magnus188/aegir/README.md

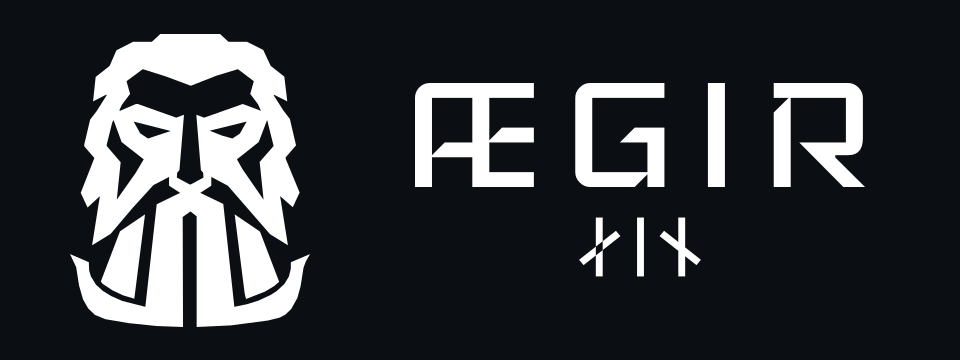
[picture p1: logo/aegir-lockup-dark.png]
Ægir 1 logo


Ægir is a work-in-progress trimix gas analyzer for technical diving. It is not
qualified as a breathing-gas safety instrument; use it at your own risk.

Made in Norway 🇳🇴.

## The name

In Norse mythology, Ægir (/ˈæːɣir/) is the giant who rules the sea. He is
known for hosting the gods in his halls adorned with gold and, together with
Rán, is the father of nine daughters who personify the waves.

The runes ᛅᛁᚾ are a Viking Age-style representation of einn, Old Norse for
“one”, marking the first version of the project: Ægir 1.

## Features

- Oxygen (O₂) and helium (He) sensor inputs, plus CO monitoring
- 4.3-inch touch screen for gas analysis, calibration and settings
- Mix calculations, dive planning and analysis history
- Desktop simulator with demo readings

**[Try the interactive browser demo](https://magnus188.github.io/aegir/).**

## Device design

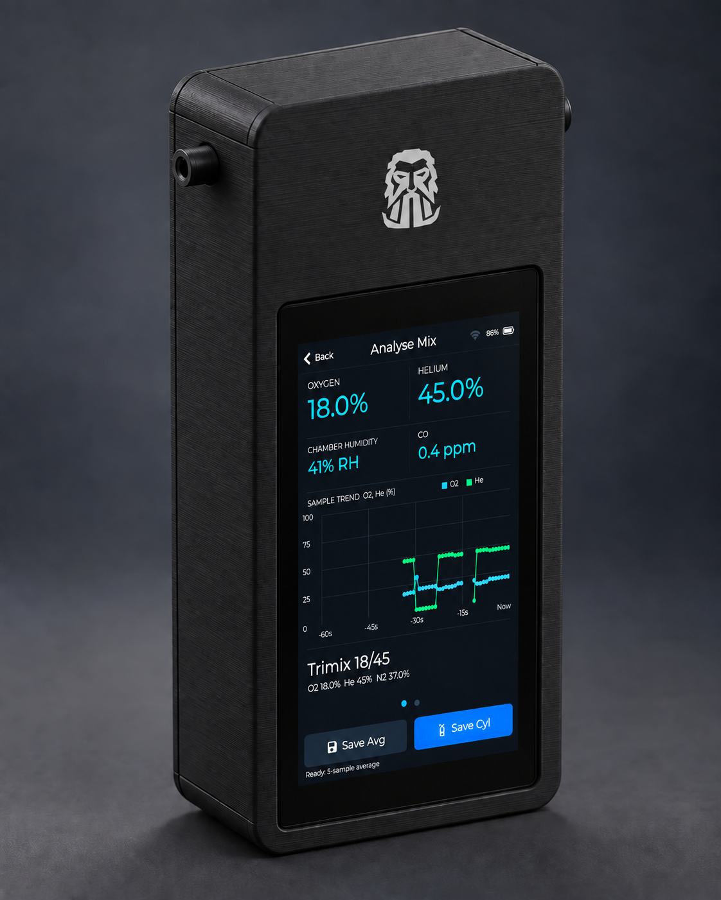
[picture p2: media/aegir-device-concept-render.png]
Concept render of the Ægir handheld trimix analyzer with a black 3D-printed case, white logo, plastic gas fittings and portrait touchscreen


*Concept render of the proposed enclosure and interface.*

## PCB and enclosure

The current prototype uses one PCB with a bottom-facing GCT USB4105-GF-A
USB-C connector. The matching enclosure retains the protected battery holder
and adds support around the connector.

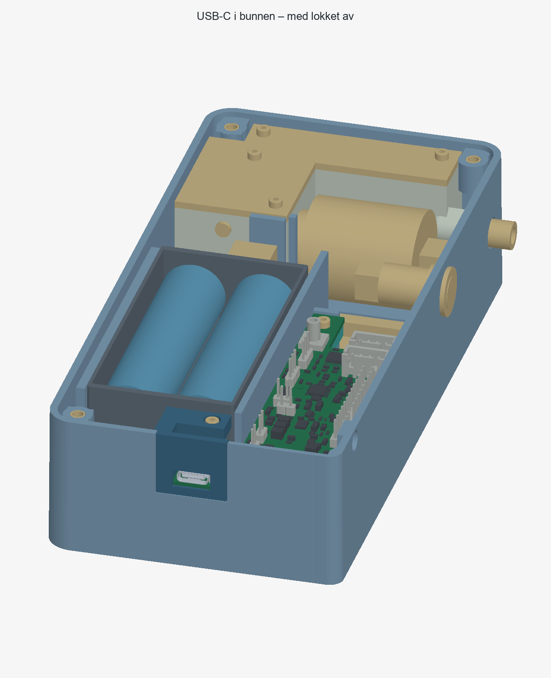
[picture p3: hardware/cad/pcb-v2-bottom/views/usb-bottom-open.png]
Current enclosure with integrated PCB and bottom USB-C support


Open the [KiCad project](hardware/pcb/analyzer-v2-bottom/Trimix_Analyzer.kicad_pro)
and [Fusion model](hardware/cad/pcb-v2-bottom/Trimix_Enclosure_PCB2_Bottom.f3d).
The [hardware guide](hardware/PCB2-BOTTOM.txt) describes the current files and
remaining prototype checks. Supplier and physical qualification are pending.

## Screenshots

These screens show the simulator with demo data. Swipe horizontally between
live analysis and analysis details; simulator profiles are in the top status banner.

| Main menu | Live analysis | Analysis details |
| :---: | :---: | :---: |
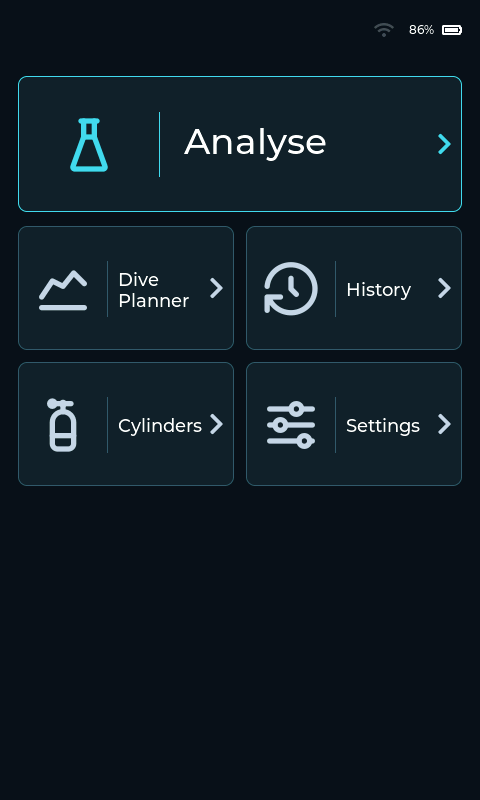
[picture p4: software/firmware/docs/screenshots/main-menu.png]
Main menu with Tabler icons
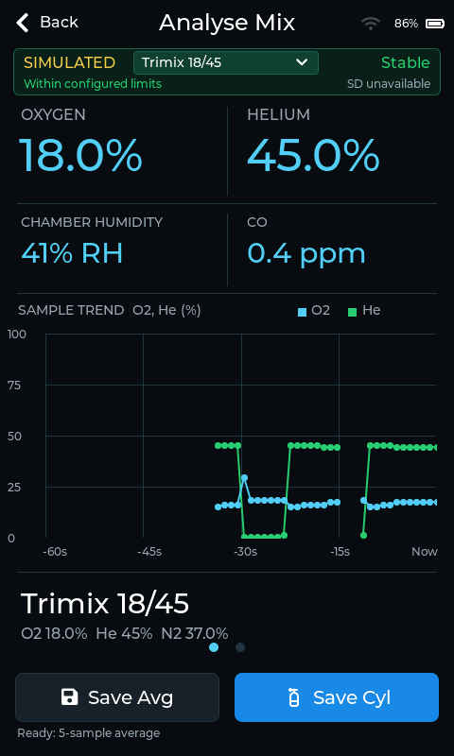
[picture p5: software/firmware/docs/screenshots/analysis-live.png]
Live gas analysis and sample graph
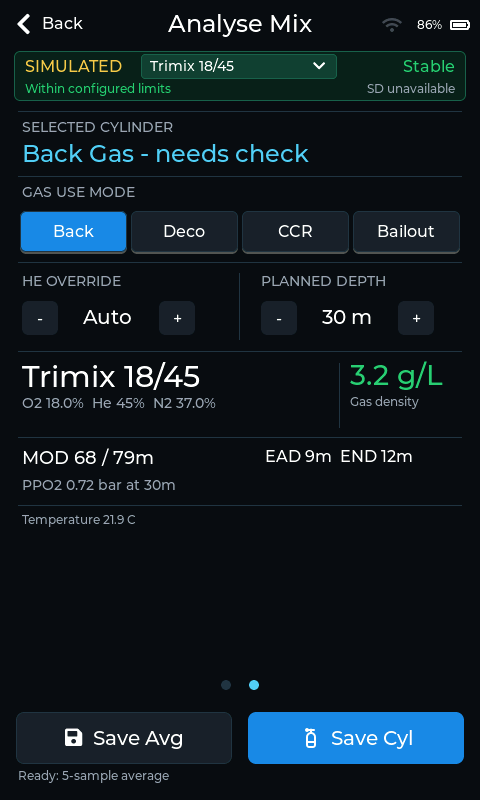
[picture p6: software/firmware/docs/screenshots/analysis-planning.png]
Selected cylinder and gas analysis details
|  |  |  |

| History | Cylinders | Settings |
| :---: | :---: | :---: |
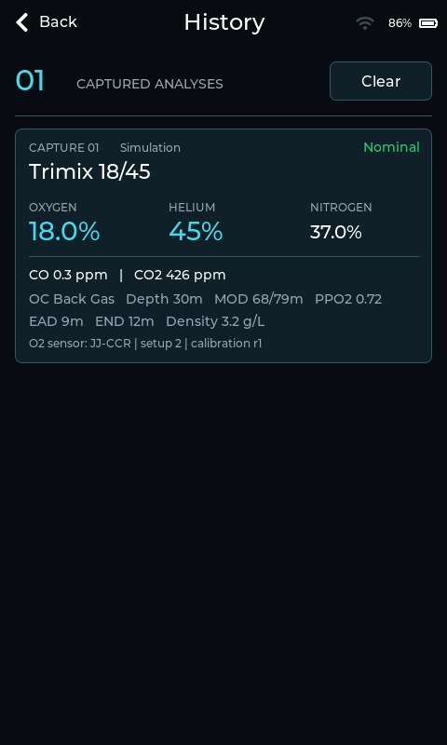
[picture p7: software/firmware/docs/screenshots/history.png]
Captured analysis history
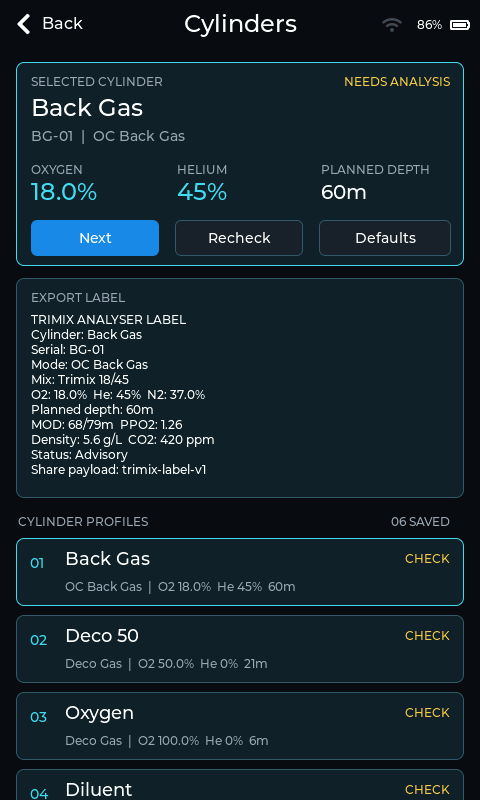
[picture p8: software/firmware/docs/screenshots/cylinders.png]
Cylinder profiles and export label
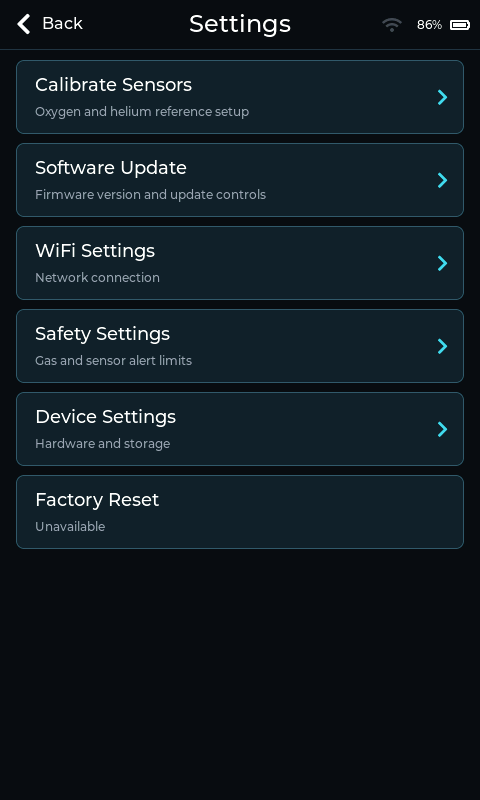
[picture p9: software/firmware/docs/screenshots/settings.png]
Settings menu
|  |  |  |

| Dive Planner | Device Settings |
| :---: | :---: |
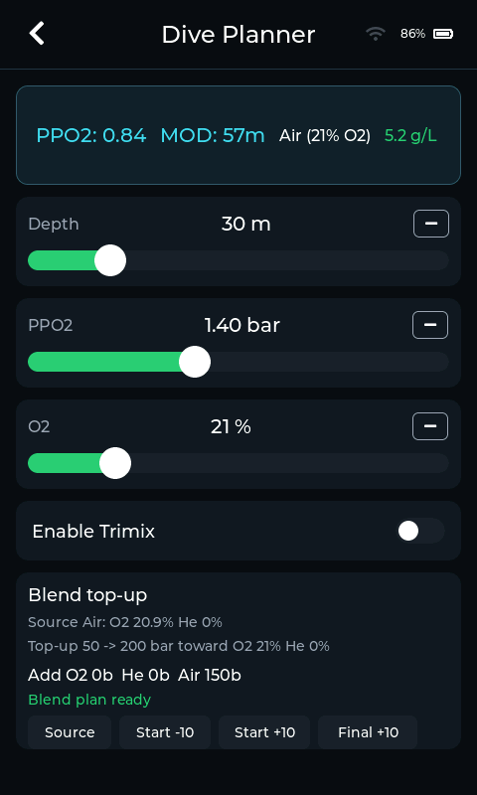
[picture p10: software/firmware/docs/screenshots/dive-planner.png]
Dive Planner with dark instrument header
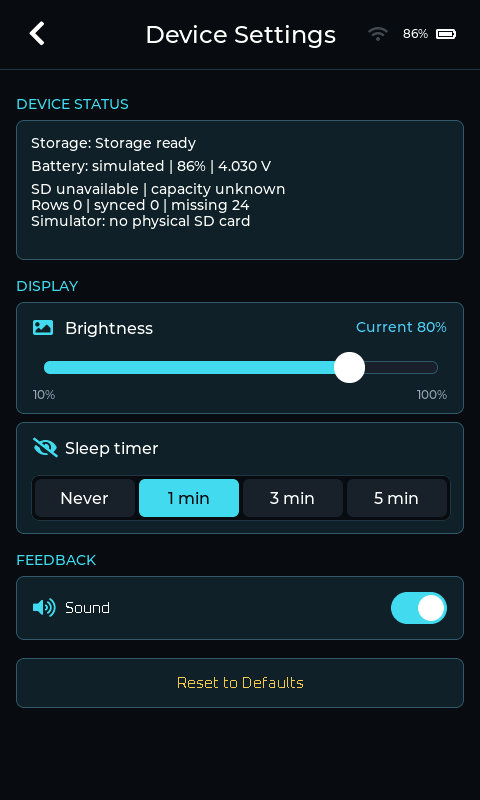
[picture p11: software/firmware/docs/screenshots/device-settings.png]
Device status with brightness slider and sleep controls
|  |  |

| Simulated high CO alert | Safety Settings |
| :---: | :---: |
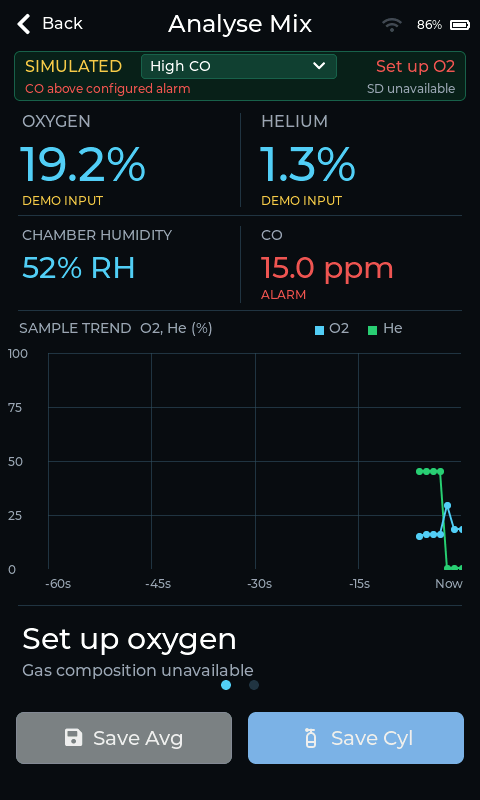
[picture p12: software/firmware/docs/screenshots/analysis-high-co.png]
Analyse shows a red CO alarm in the simulator
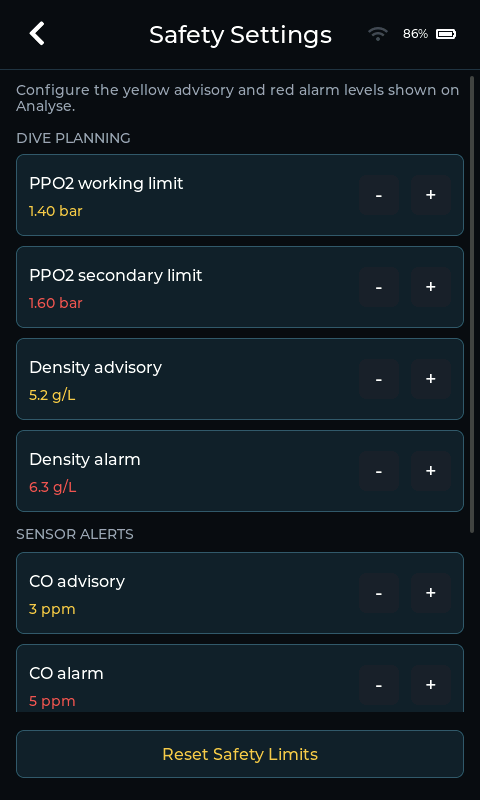
[picture p13: software/firmware/docs/screenshots/safety-settings.png]
Configurable advisory and alarm limits
|  |  |

## Run it

For the desktop simulator, install a C++ compiler, CMake, `pkg-config` and SDL2,
then run from the repository root:

```sh
make sim-deps
make sim ZOOM=0.75
```

Run the host tests with `make test`.

To build and flash the firmware on the Guition JC4880P443C_I_W ESP32-P4 board,
install Python 3.13 and run:

```sh
make setup-idf
make devices
make board-info PORT=/dev/cu.usbserial-110
make push PORT=/dev/cu.usbserial-110
```

Replace the example `PORT` with the port reported by `make devices`. See the
[firmware guide](software/firmware/README.md) for other build options.

## Files

- [Firmware and simulator](software/firmware/)
- [Current PCB 2.0 prototype](hardware/pcb/analyzer-v2-bottom/Trimix_Analyzer.kicad_pro), with integrated USB-C facing the bottom
- [Current enclosure CAD](hardware/cad/pcb-v2-bottom/Trimix_Enclosure_PCB2_Bottom.f3d), [STEP](hardware/cad/pcb-v2-bottom/Trimix_Enclosure_PCB2_Bottom.step) [H2D print bed](hardware/cad/pcb-v2-bottom/Trimix_PCB2_Bottom_H2D.3mf) and [STL package](hardware/cad/pcb-v2-bottom/Trimix_PCB2_Bottom_PrintParts.zip)
- [Hardware package guide and qualification status](hardware/PCB2-BOTTOM.txt); superseded deliverables remain in Git history
- [Logo](logo/README.md)

## Contributing and future ideas

Design reviews, measurements, documentation and software fixes are welcome.
Start with the [contribution guide](CONTRIBUTING.md) and
[open issues](https://github.com/magnus188/aegir/issues). The
[v2 investigation backlog](https://github.com/magnus188/aegir/milestone/1)
collects community suggestions without promising a release date.

Maintainers can use the [repository guide](.github/MAINTAINING.md). For
exploitable vulnerabilities, use the [private reporting route](SECURITY.md).

## Acknowledgements

A big thank you to [@tobiasruber](https://github.com/tobiasruber) for reviewing and
improving the PCB design. His help is a big reason this project is still alive
and moving forward.

## License

Software: [GPLv3](LICENSES/GPL-3.0-only.txt). PCB and CAD files:
[CERN-OHL-S-2.0](LICENSES/CERN-OHL-S-2.0.txt). The Ægir name and logo have a
separate [brand policy](logo/LICENSE.md). See the [license map](LICENSE.md)
for details and third-party files.
