magnus188/aegir/hardware/pcb/usb-input/reference/README.md

# Manufacturer reference

`GCT_USB4720_RevB_drawing.pdf` is the GCT USB4720 connector drawing retained
for land, cutout and mating-interface review. The
[manufacturer's published drawing](https://gct.co/files/drawings/usb4720.pdf)
is the source. This third-party document is not part of the project's own
design license.
