magnus188/aegir/hardware/cad/pcb-v2-bottom/FESTEMATERIELL-ENDREDE-FESTER.csv

Del | Antall | Bruk | Merknad
M2 x 7 mm | 2 | Kortfester | Samme skruelengde som tidligere
M2 x 5 mm | 2 | USB-støtte | Gjenbruk av tidligere USB-skruer
TC-M2x3.0 varmeinnsats | 4 | To kortfester og to USB-fester | Eksakt lagerbeholdning ikke bekreftet; prøv faktisk innsats i testutskrift
M3 x 8 mm | 4 | Baklokk | Tre bakfra og én fra høyre side; gjenbruk av opprinnelige skruer
Opprinnelig M3-innsats OD4.2 x5 | 4 | Baklokk | Tre i hovedhuset og én i den nye fliken på lokket; øvrige fester videreføres
