magnus188/aegir/media/reddit/aegir-product-concept-unbranded.png

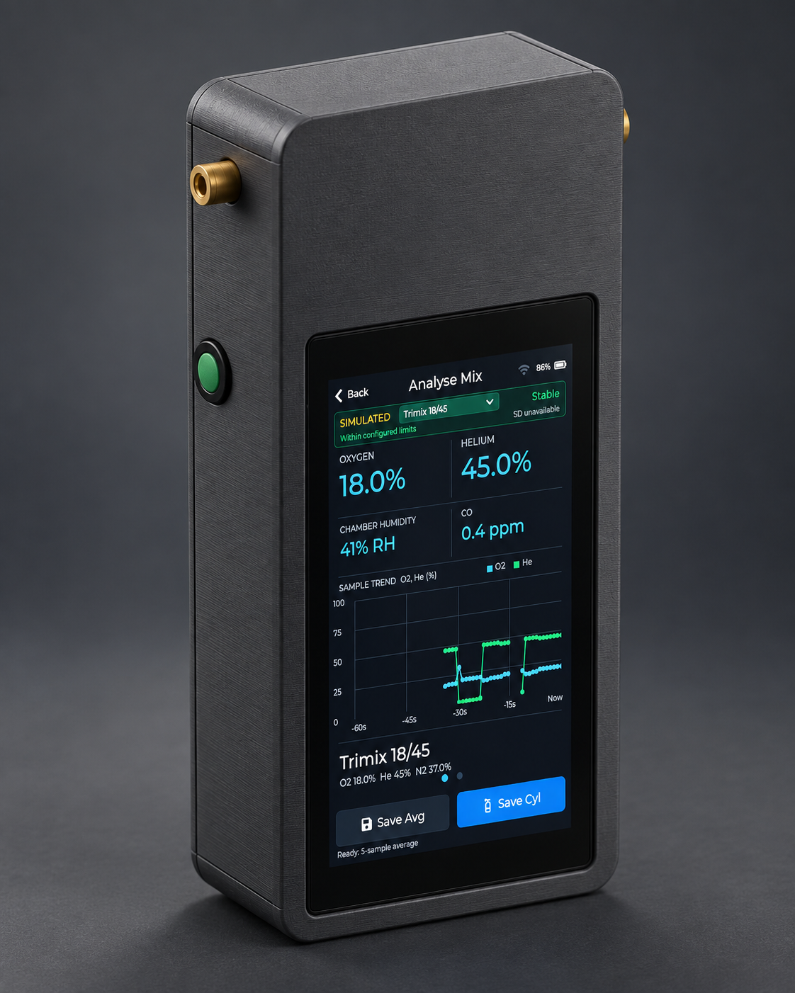
media/reddit/aegir-product-concept-unbranded.png
