magnus188/aegir/media/reddit/aegir-product-concept-v2.png

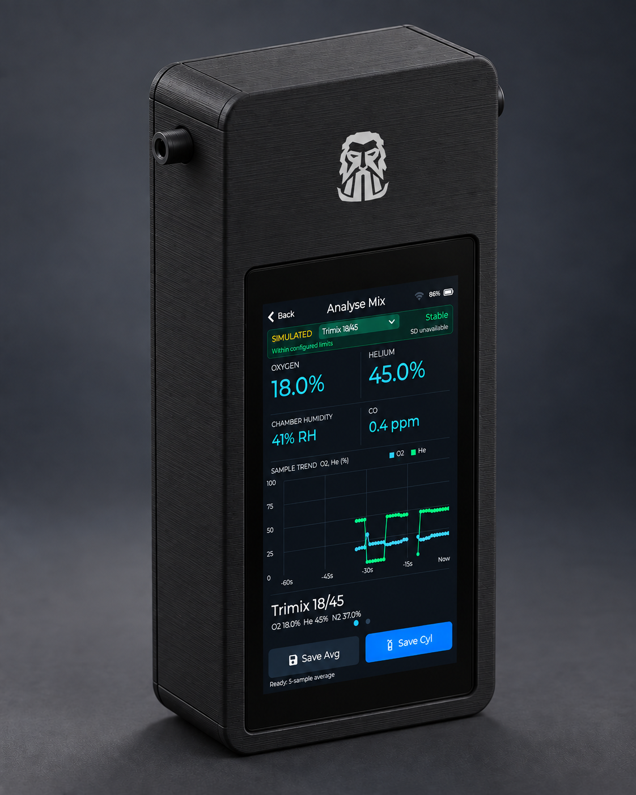
media/reddit/aegir-product-concept-v2.png
