magnus188/aegir/media/renders/aegir-exploded.png

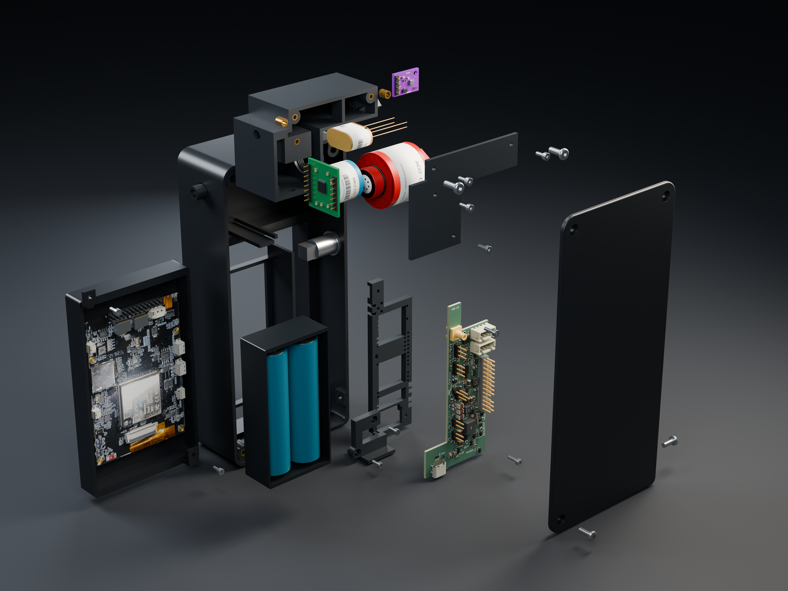
media/renders/aegir-exploded.png
