magnus188/aegir/media/renders/aegir-portrait.png

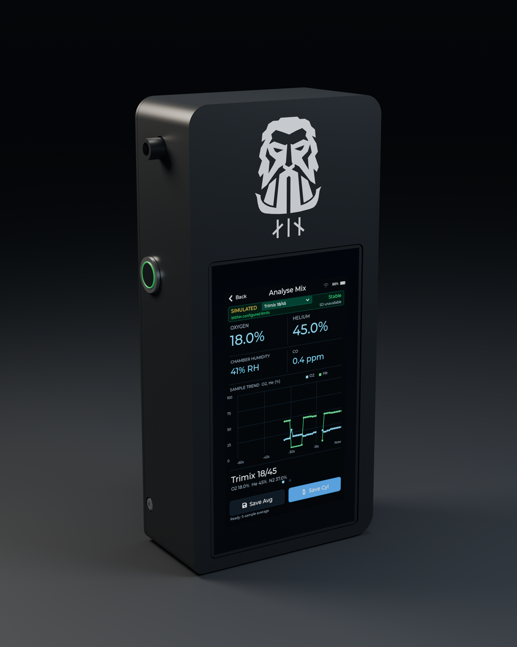
media/renders/aegir-portrait.png
