magnus188/aegir/media/renders/references/display/guition-rear-rectified.png

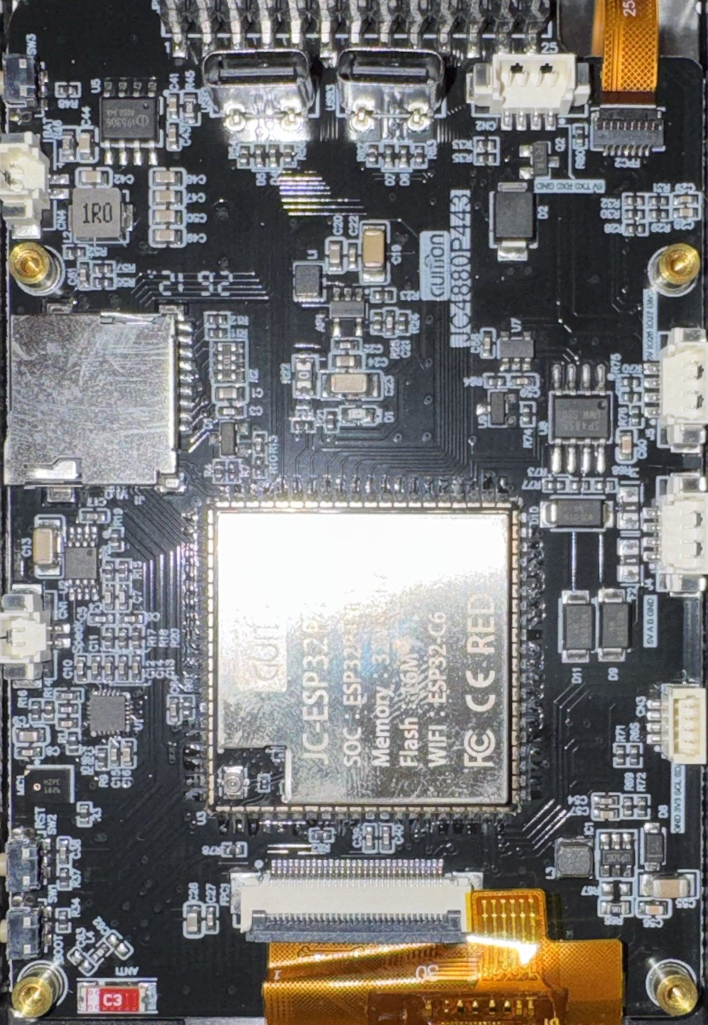
media/renders/references/display/guition-rear-rectified.png
