magnus188/aegir/media/renders/references/sensors/ao2-drawing.png

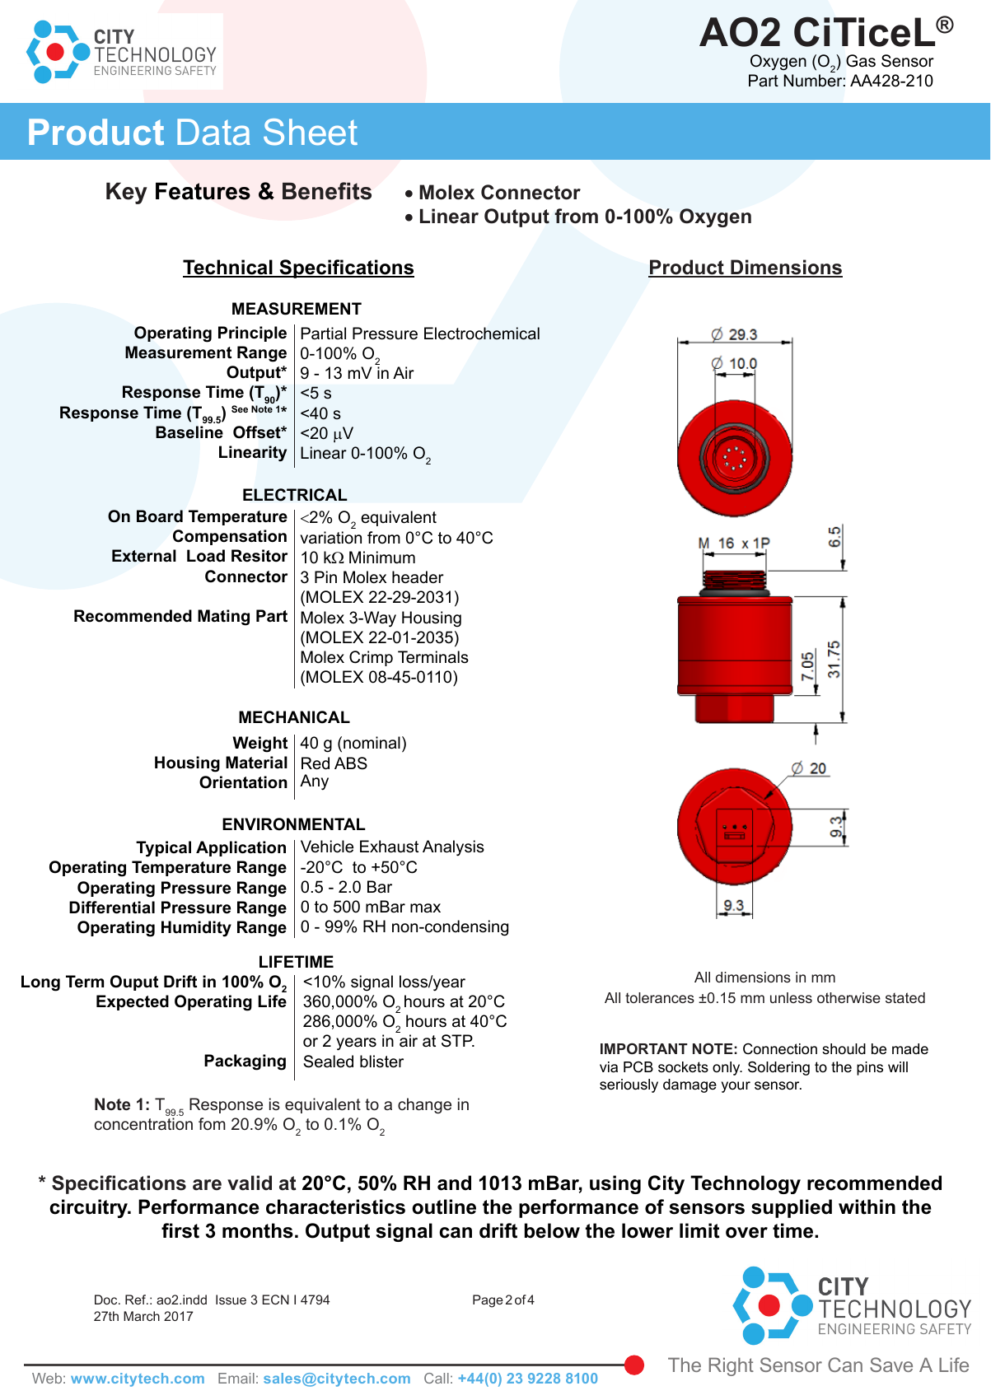
media/renders/references/sensors/ao2-drawing.png
