magnus188/aegir/media/renders/references/sensors/ao2-label.png

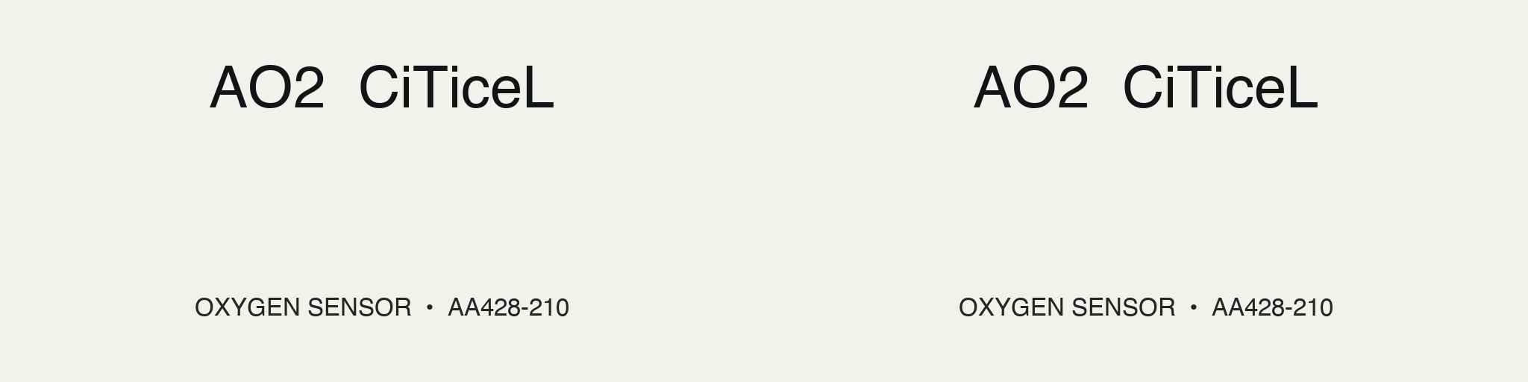
media/renders/references/sensors/ao2-label.png
