magnus188/aegir/media/renders/references/sensors/md62-label.png

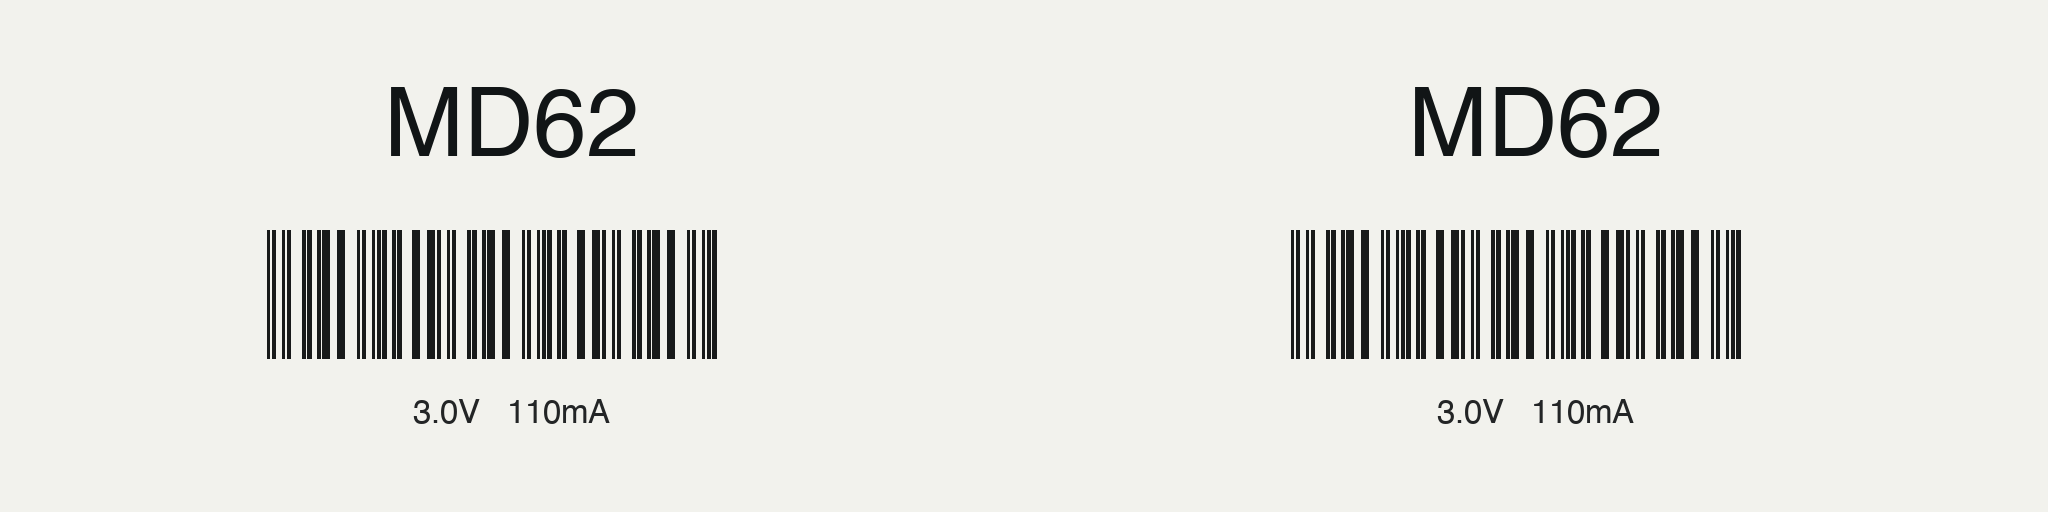
media/renders/references/sensors/md62-label.png
