magnus188/aegir/media/renders/references/sensors/ze07-co.jpg

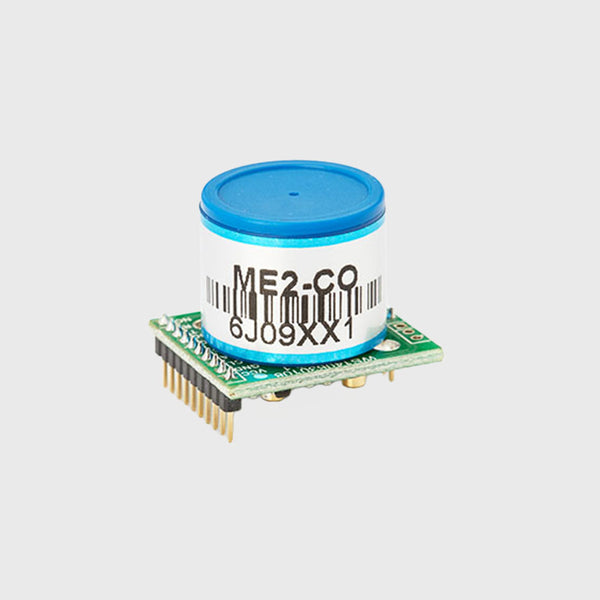
media/renders/references/sensors/ze07-co.jpg
