magnus188/aegir/hardware/pcb/analyzer-v2-bottom/manufacturing/bom-populated-grouped.csv

References | Manufacturer | MPN | Footprint | Quantity_per_board | Quantity_for_2_assembled_boards | Values
J402 | Amphenol RF | 142138 | SMB_Amphenol_142138 | 1 | 2 | SMB male-centre / Amphenol142138
U801 | Analog Devices | LTC2954CTS8-1#TRMPBF | TSOT-23-8 | 1 | 2 | LTC2954CTS8-1
U301 | Analog Devices | MAX17048G+T10 | TDFN-8-1EP_2x2mm_P0.5mm_EP0.8x1.2mm | 1 | 2 | MAX17048G+
L701 | Coilcraft | XGL4020-102MEC | L_Coilcraft_XGL4020 | 1 | 2 | 1u / XGL4020-102MEC
L201 | Coilcraft | XGL4030-152MEC | L_Coilcraft_XGL4030 | 1 | 2 | 1.5u / XGL4030-152MEC
Q101 | Diodes Incorporated | 2N7002-7-F | SOT-23 | 1 | 2 | 2N7002
Q601, Q602 | Diodes Incorporated | BSS138-7-F | SOT-23 | 2 | 4 | BSS138
Q110 | Diodes Incorporated | DMN2056U-7 | DMN2056U_SOT23_Diodes_Recommended | 1 | 2 | DMN2056U-7
Q111, Q112 | Diodes Incorporated | DMN2056U-7 | SOT-23 | 2 | 4 | DMN2056U-7
U111 | Diodes Incorporated | PI3USB9201ZTAEX | PI3USB9201_UQFN2020_12_TypeC | 1 | 2 | PI3USB9201ZTAEX
J901 | GCT | USB4105-GF-A | USB_C_Receptacle_GCT_USB4105_GF_A_GroundLandOffset025 | 1 | 2 | USB4105-GF-A
J103, J104, J801, J802 | Harwin | M20-9990246 | PinHeader_1x02_P2.54mm_Vertical | 4 | 8 | ARM: OPEN | BUTTON LED +/- | PACK NTC: 103AT-2 | POWER BUTTON / 1NO
J401, J501 | Harwin | M20-9990346 | PinHeader_1x03_P2.54mm_Vertical | 2 | 4 | AO2 / 3-pin cable | MD62 cable / <=30 cm
J601, J701 | JST | B4B-XH-A(LF)(SN) | JST_XH_B4B-XH-A_1x04_P2.50mm_Vertical | 2 | 4 | BME280 harness | ZE07-CO harness
C101, C401, C404, C408, C409, C505, C509, C804 | KEMET / YAGEO | C0603C105K4RACTU | C_0603_1608Metric | 8 | 16 | 1u / 16V X7R / 10%
C301, C707, C708 | KEMET / YAGEO | C0805C104K5RACTU | C_0805_2012Metric | 3 | 6 | 100n / 50V X7R / 10%
C803 | KEMET / YAGEO | C0805C333K5RACTU | C_0805_2012Metric | 1 | 2 | 33n / 50V X7R / 10%
C116 | Murata | GRM1555C1H332JE01D | C_0402_1005Metric | 1 | 2 | 3.3n / 50V C0G / 5%
J301 | Samtec | HTSW-113-07-L-D-007 | Samtec_HTSW-113-07-L-D-007_P2.54mm_Key7 | 1 | 2 | GUITION JP1 / 2x13
C103 | TDK | C1005X7R1H473K050BE | C_TDK_C1005_Recommended | 1 | 2 | 47n / 50V X7R / 10%
C108, C302, C303, C501, C502 | TDK | C1608X5R1C475K080AC | C_0603_1608Metric | 5 | 10 | 4.7u / 16V X5R / 10%
C402, C403, C405, C406, C506, C507 | TDK | C1608X7R1H103K080AA | C_0603_1608Metric | 6 | 12 | 10n / 50V X7R / 10%
C110, C111, C112, C113, C115, C203, C407, C504, C508, C801, C802 | TDK | C1608X7R1H104K080AA | C_0603_1608Metric | 11 | 22 | 100n / 50V X7R | 100n / 50V X7R / 10%
C107 | TDK | C2012X5R1A476M125AC | C_TDK_C2012_Recommended | 1 | 2 | 47u / 10V X5R / 20%
C702, C703 | TDK | C2012X5R1C226M125AC | C_0805_2012Metric | 2 | 4 | 22u / 16V X5R / 20%
C601, C704, C705 | TDK | C2012X7R1E105K125AB | C_0805_2012Metric | 3 | 6 | 1u / 25V X7R / 10%
C106, C201, C202, C701 | TDK | C3216X5R1E226M160AB | C_1206_3216Metric | 4 | 8 | 22u / 25V X5R / 20%
C114 | TDK | C3216X7R1E475K160AC | C_1206_3216Metric | 1 | 2 | 4.7u / 25V X7R / 10%
C102, C104, C105, C204, C205, C206 | TDK | C3225X7R1C226M250AC | C_1210_3225Metric | 6 | 12 | 22u / 16V X7R / 20%
U401, U502 | Texas Instruments | ADS122C04IPWR | TSSOP-16_4.4x5mm_P0.65mm | 2 | 4 | ADS122C04IPWR
U101 | Texas Instruments | BQ25895RTWR | TI_RTW24_4x4_ThermalVias_ServicePad | 1 | 2 | BQ25895RTWR
U302 | Texas Instruments | LM66100DCKR | SOT-363_SC-70-6 | 1 | 2 | LM66100DCKR
U112 | Texas Instruments | SN74AUP1G74DCUR | VSSOP-8_2.3x2mm_P0.5mm | 1 | 2 | SN74AUP1G74DCUR
D901 | Texas Instruments | TPD1E10B06DYAR | TI_DYA0002A | 1 | 2 | TPD1E10B06DYAR
U901 | Texas Instruments | TPD4E05U06DQAR | TI_DQA0010B | 1 | 2 | TPD4E05U06DQAR
U114 | Texas Instruments | TPS22950CQDDCRQ1 | TI_DDC0006A | 1 | 2 | TPS22950CQDDCRQ1
U115 | Texas Instruments | TPS259470ARPWR | TI_RPW0010A | 1 | 2 | TPS259470ARPWR
U113 | Texas Instruments | TPS3808G01DBVR | SOT-23-6 | 1 | 2 | TPS3808G01DBVR
U701 | Texas Instruments | TPS61023DRLR | SOT-563 | 1 | 2 | TPS61023DRLR
U201 | Texas Instruments | TPS63020DSJR | TI_DSJ_14 | 1 | 2 | TPS63020DSJR
U501, U702 | Texas Instruments | TPS7A2030PDBVR | SOT-23-5 | 2 | 4 | TPS7A2030PDBVR
U110 | Texas Instruments | TUSB320LAIRWBR | Texas_X2QFN-12_1.6x1.6mm_P0.4mm | 1 | 2 | TUSB320LAIRWBR
U703 | Texas Instruments | TXU0202DCUR | TI_DCU8_CompactSilk | 1 | 2 | TXU0202DCUR
R125 | Vishay | TNPW060310K0BEEA | R_0603_1608Metric | 1 | 2 | 10k / 0.1% / 25ppm
R123 | Vishay | TNPW060310K0BYEA | R_0603_1608Metric | 1 | 2 | 10k / 0.1% / 10ppm
R126 | Vishay | TNPW06031K65BEEA | R_0603_1608Metric | 1 | 2 | 1.65k / 0.1%
R124 | Vishay | TNPW060321K5BEEA | R_0603_1608Metric | 1 | 2 | 21.5k / 0.1% / 25ppm
R121 | Vishay | TNPW060334K0BYEA | R_0603_1608Metric | 1 | 2 | 34k / 0.1% / 10ppm
R122 | Vishay | TNPW0603649RBYEA | R_0603_1608Metric | 1 | 2 | 649R / 0.1% / 10ppm
RN501 | Vishay Beyschlag | ACASN2001U2001P1AT | Vishay_ACAS0606_AT_IEC | 1 | 2 | 2x2k / 1:1 matched
L101 | Würth Elektronik | 74437349010 | L_Wurth_74437349010_7050 | 1 | 2 | 1u / 74437349010
R101 | YAGEO | RC0402FR-075K23L | R_0402_1005Metric | 1 | 2 | 5.23k 1%
R104, R105, R117, R128, R203, R501, R703, R803 | YAGEO | RC0603FR-07100KL | R_0603_1608Metric | 8 | 16 | 100k | 100k / 1%
R704, R705 | YAGEO | RC0603FR-07100RL | R_0603_1608Metric | 2 | 4 | 100R
R107, R112, R120, R127, R301, R802 | YAGEO | RC0603FR-0710KL | R_0603_1608Metric | 6 | 12 | 10k | 10k / 1%
R202 | YAGEO | RC0603FR-07180KL | R_0603_1608Metric | 1 | 2 | 180k 1%
R201 | YAGEO | RC0603FR-071M62L | R_0603_1608Metric | 1 | 2 | 1.62M 1%
R403, R404, R407, R408 | YAGEO | RC0603FR-071ML | R_0603_1608Metric | 4 | 8 | 1M / 1%
R103 | YAGEO | RC0603FR-07300RL | R_0603_1608Metric | 1 | 2 | 300R / 1% / supported ILIM range
R102 | YAGEO | RC0603FR-0730K1L | R_0603_1608Metric | 1 | 2 | 30.1k 1%
R111 | YAGEO | RC0603FR-0733KL | R_0603_1608Metric | 1 | 2 | 33k / 1%
R302, R303 | YAGEO | RC0603FR-074K7L | R_0603_1608Metric | 2 | 4 | 4.7k / FIT
R801 | YAGEO | RC0603FR-075K1L | R_0603_1608Metric | 1 | 2 | 5.1k
R110 | YAGEO | RC0603FR-07887KL | R_0603_1608Metric | 1 | 2 | 887k / 1%
R601 | YAGEO | RC0603JR-070RL | R_0603_1608Metric | 1 | 2 | 0R / fit: 3.3 V
R118, R702 | YAGEO | RT0402BRD07100KL | R_0402_1005Metric | 2 | 4 | 100k / 0.1%
R115 | YAGEO | RT0402BRD0710KL | R_0402_1005Metric | 1 | 2 | 10k / 0.1%
R119 | YAGEO | RT0402BRD0719K1L | R_0402_1005Metric | 1 | 2 | 19.1k / 0.1%
R401, R402, R405, R406 | YAGEO | RT0603BRD07100RL | R_0603_1608Metric | 4 | 8 | 100R / 0.1%
R114, R409, R410, R504, R505 | YAGEO | RT0603BRD0710KL | R_0603_1608Metric | 5 | 10 | 10k / 0.1%
R116 | YAGEO | RT0603BRD071KL | R_0603_1608Metric | 1 | 2 | 1k / 0.1%
R506, R507 | YAGEO | RT0603BRD07680RL | R_0603_1608Metric | 2 | 4 | 680R / 0.1%
R701 | YAGEO | RT0603BRD07787KL | R_0603_1608Metric | 1 | 2 | 787k / 0.1%
R113 | YAGEO | RT0603BRD0797K6L | R_0603_1608Metric | 1 | 2 | 97.6k / 0.1%
