magnus188/aegir/hardware/cad/pcb-v2-bottom/parts/TMX-A3-P01.step

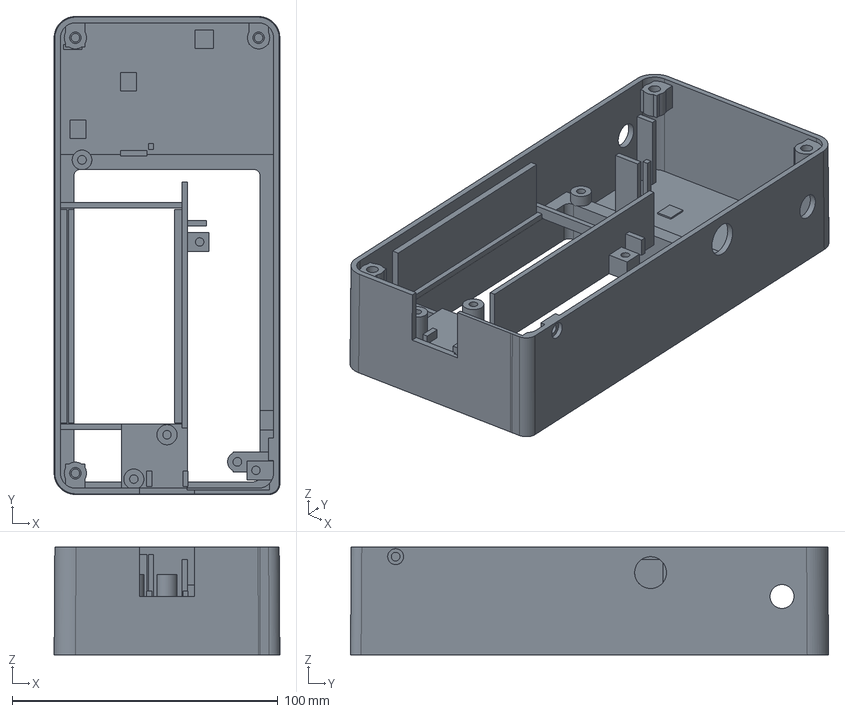
[picture p32: CAD file, 2026-10-17]
hardware/cad/pcb-v2-bottom/parts/TMX-A3-P01.step
85.0 x 180.0 x 40.6 mm
