magnus188/aegir/hardware/cad/pcb-v2-bottom/Trimix_PCB2_Bottom_H2D.3mf

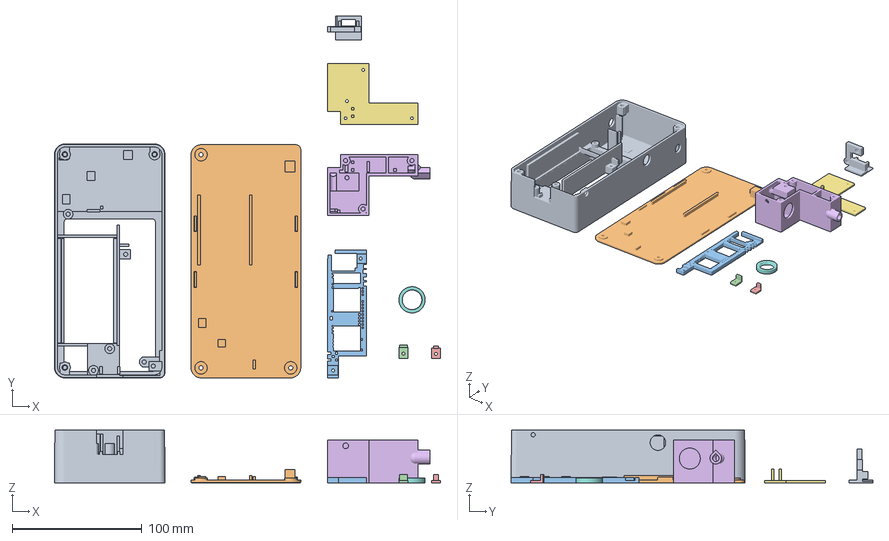
[picture p33: CAD file, 2026-10-17]
hardware/cad/pcb-v2-bottom/Trimix_PCB2_Bottom_H2D.3mf
297.0 x 278.4 x 40.6 mm
TMX-A3-P01
TMX-A3-P02
TMX-A3-P03
TMX-A3-P04
TMX-A3-P05
TMX-A3-P07
TMX-A3-P08
TMX-A3-P11
TMX-V2-P12
