magnus188/aegir/hardware/pcb/analyzer-v2-bottom/review/Trimix_PCB_V2_Bottom_Mechanical.step

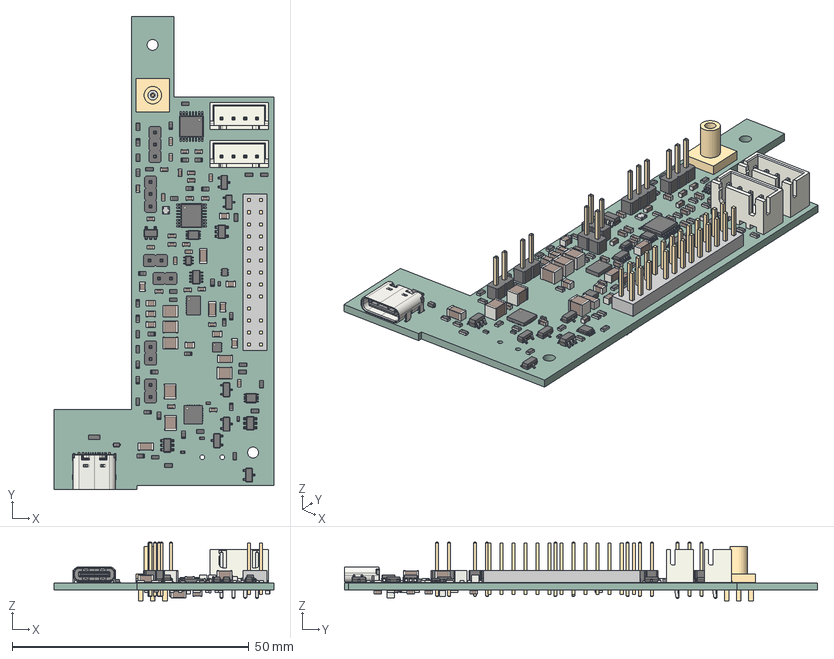
[picture p34: CAD file, 2026-10-17]
hardware/pcb/analyzer-v2-bottom/review/Trimix_PCB_V2_Bottom_Mechanical.step
46.4 x 99.8 x 12.4 mm
C_0603_1608Metric x 31
R_0402_1005Metric x 5
R_0603_1608Metric x 54
C_1210_3225Metric x 6
C_0402_1005Metric x 2
SOT-23 x 6
PinHeader_1x03_P254mm_Vertical x 2
JST_B4B_XH_A x 2
C_1206_3216Metric x 5
C_0805_2012Metric x 11
SOT-23-5 x 2
PinHeader_1x02_P254mm_Vertical x 4
Amphenol RF 142138 - drawing reconstruction; mating details reference
(Unsaved)
SOT_563
SOT-23-6 x 2
VSSOP-8_2.3x2mm_P0.5mm x 2
TSOT-23-8
Samtec HTSW-113-07-L-D-007 nominal drawing reconstruction
DFN_8_1EP_2x2mm_P05mm_EP07x13mm
DFN-14-1EP_3x4mm_Pitch0.5mm
TSSOP-16_4.4x5mm_P0.65mm x 2
USB_C_Receptacle_16P_TopMnt_Horizontal_GCT_USB4105-xx-A
Texas_RTW_WQFN-24-1EP_4x4mm_P0.5mm_EP2.7x2.7mm
D_SOD_523
SOT-363_SC-70-6
USON_10_25x10mm_Pitch05mm
Trimix_Analyzer_PCB
