magnus188/aegir/hardware/cad/pcb-v2-bottom/parts/TMX-V2-P12.step

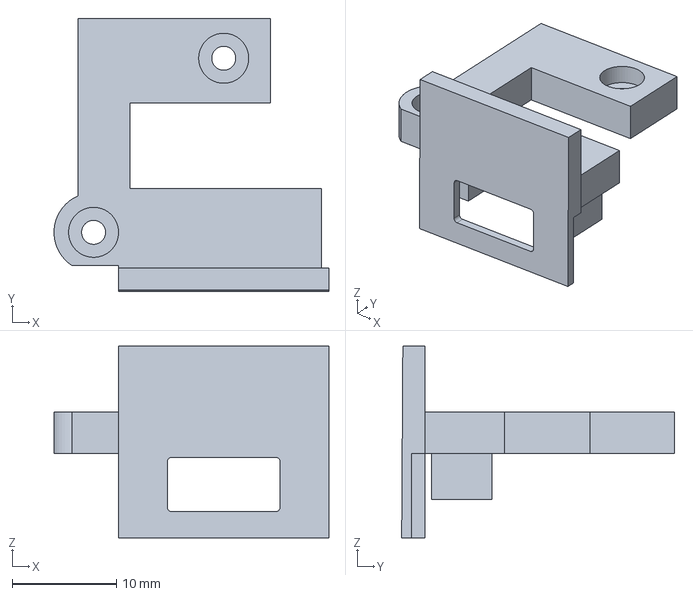
[picture p35: CAD file, 2026-10-17]
hardware/cad/pcb-v2-bottom/parts/TMX-V2-P12.step
26.4 x 26.2 x 18.4 mm
