magnus188/aegir/(list of files, cad)

Other CAD files:
hardware/cad/pcb-v2-bottom/parts/TMX-A3-P01.stl
hardware/cad/pcb-v2-bottom/parts/TMX-V2-P12.stl
media/renders/aegir-exploded.blend
media/renders/aegir-portrait.blend
