magnus188/aegir/media/renders/references/sensors/geometry-qa.png

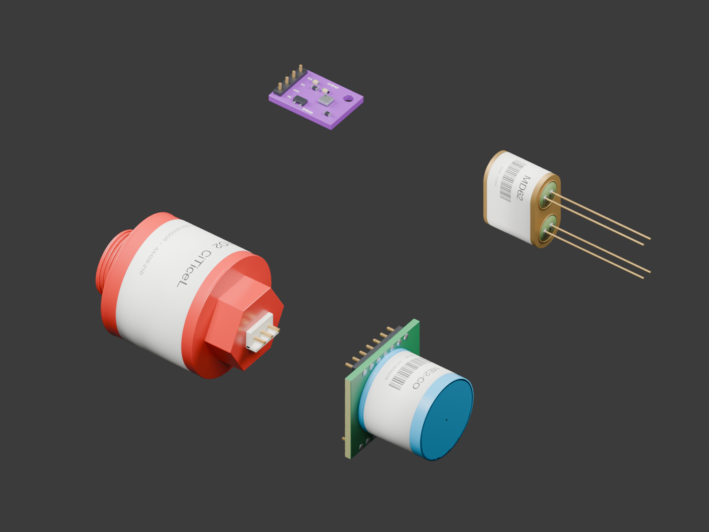
media/renders/references/sensors/geometry-qa.png
