magnus188/aegir/hardware/pcb/analyzer/Trimix_Analyzer.kicad_pcb

## KiCad design hardware/pcb/analyzer/Trimix_Analyzer.kicad_pcb (2026-10-11)

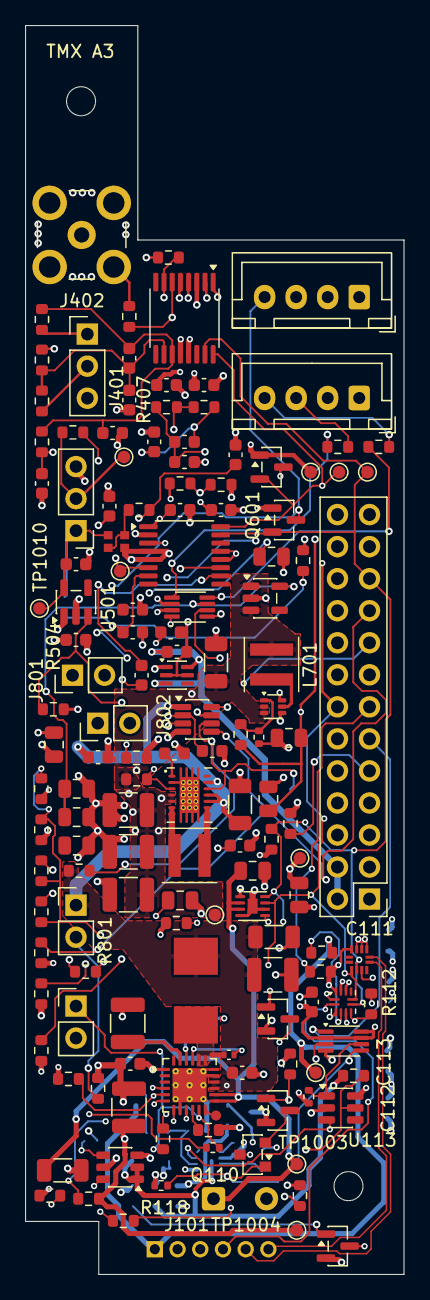
[picture p37: board Trimix_Analyzer.kicad_pcb from above]

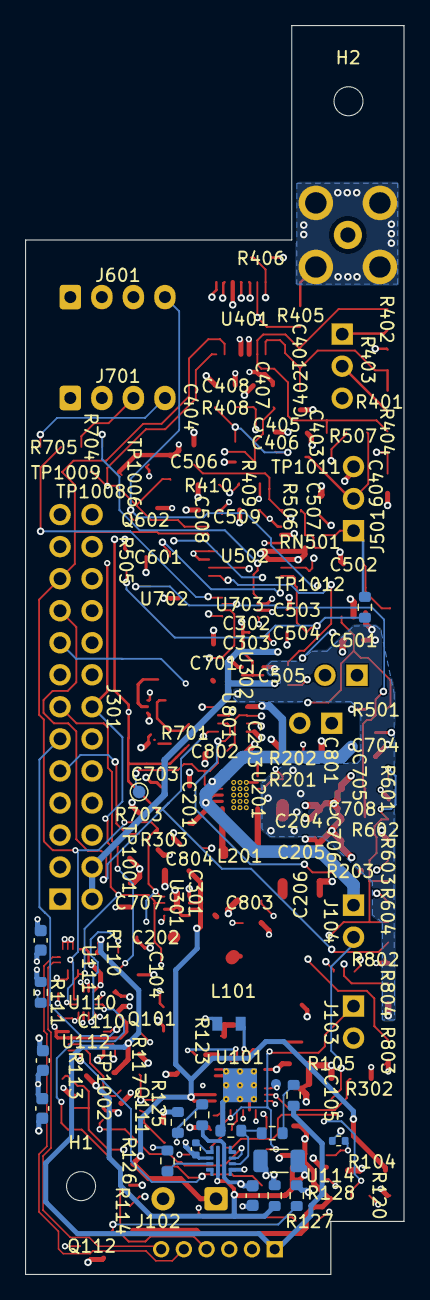
[picture p38: board Trimix_Analyzer.kicad_pcb from below]

Board: 4 copper layers, 30.0 x 99.0 mm, 169 parts (21 on the bottom side), 86 nets.

Parts:
C101, C401, C404, C408, C409, C505, C509, C804: 1u / 16V X7R / 10%; C_0603_1608Metric
C102, C104, C105, C204, C205, C206: 22u / 16V X7R / 20%; C_1210_3225Metric
C103: 47n / 50V X7R / 10%; C_TDK_C1005_Recommended
C106, C201, C202, C701: 22u / 25V X5R / 20%; C_1206_3216Metric
C107: 47u / 10V X5R / 20%; C_TDK_C2012_Recommended
C108, C302, C303, C501, C502: 4.7u / 16V X5R / 10%; C_0603_1608Metric
C110, C111, C112, C113, C203, C407, C504, C508, C801, C802: 100n / 50V X7R / 10%; C_0603_1608Metric
C114: 4.7u / 25V X7R / 10%; C_1206_3216Metric
C115: 100n / 50V X7R; C_0603_1608Metric
C116: 3.3n / 50V C0G / 5%; C_0402_1005Metric
C301, C707, C708: 100n / 50V X7R / 10%; C_0805_2012Metric
C402, C403, C405, C406, C506, C507: 10n / 50V X7R / 10%; C_0603_1608Metric
C503: 10n / 50V X7R / 10% / DNP; C_0603_1608Metric
C601, C704, C705: 1u / 25V X7R / 10%; C_0805_2012Metric
C702, C703: 22u / 16V X5R / 20%; C_0805_2012Metric
C706: 10n / 50V X7R / 10% / DNP; C_0805_2012Metric
C803: 33n / 50V X7R / 10%; C_0805_2012Metric
H1, H2: M2 NPTH 2.30; Mechanical_M2_NPTH_2.30mm
J101: USB HARNESS: 5V/GND/CC1/CC2/D+/D-; USB_Harness_6P_P1.8mm
J102: PACK PIGTAIL; Battery_Pigtail_2x22AWG_P4.2_D1.00_Pad1.85
J103: PACK NTC: 103AT-2; PinHeader_1x02_P2.54mm_Vertical
J104: ARM: OPEN; PinHeader_1x02_P2.54mm_Vertical
J301: GUITION JP1 / 2x13; Samtec_HTSW-113-07-L-D-007_P2.54mm_Key7
J401: AO2 / 3-pin cable; PinHeader_1x03_P2.54mm_Vertical
J402: SMB male-centre / Amphenol142138; SMB_Amphenol_142138
J501: MD62 cable / <=30 cm; PinHeader_1x03_P2.54mm_Vertical
J601: BME280 harness; JST_XH_B4B-XH-A_1x04_P2.50mm_Vertical
J701: ZE07-CO harness; JST_XH_B4B-XH-A_1x04_P2.50mm_Vertical
J801: POWER BUTTON / 1NO; PinHeader_1x02_P2.54mm_Vertical
J802: BUTTON LED +/-; PinHeader_1x02_P2.54mm_Vertical
L101: 1u / 74437349010; L_Wurth_74437349010_7050
L201: 1.5u / XGL4030-152MEC; L_Coilcraft_XGL4030
L701: 1u / XGL4020-102MEC; L_Coilcraft_XGL4020
Q101: 2N7002; SOT-23
Q110: DMN2056U-7; DMN2056U_SOT23_Diodes_Recommended
Q111, Q112: DMN2056U-7; SOT-23
Q601, Q602: BSS138; SOT-23
R101: 5.23k 1%; R_0402_1005Metric
R102: 30.1k 1%; R_0603_1608Metric
R103: 300R / 1% / supported ILIM range; R_0603_1608Metric
R104, R105, R203, R501, R703, R803: 100k; R_0603_1608Metric
R107, R301, R802: 10k; R_0603_1608Metric
R110: 887k / 1%; R_0603_1608Metric
R111: 33k / 1%; R_0603_1608Metric
R112, R120, R127: 10k / 1%; R_0603_1608Metric
R113: 97.6k / 0.1%; R_0603_1608Metric
R114, R409, R410, R504, R505: 10k / 0.1%; R_0603_1608Metric
R115: 10k / 0.1%; R_0402_1005Metric
R116: 1k / 0.1%; R_0603_1608Metric
R117, R128: 100k / 1%; R_0603_1608Metric
R118, R702: 100k / 0.1%; R_0402_1005Metric
R119: 19.1k / 0.1%; R_0402_1005Metric
R121: 34k / 0.1% / 10ppm; R_0603_1608Metric
R122: 649R / 0.1% / 10ppm; R_0603_1608Metric
R123: 10k / 0.1% / 10ppm; R_0603_1608Metric
R124: 21.5k / 0.1% / 25ppm; R_0603_1608Metric
R125: 10k / 0.1% / 25ppm; R_0603_1608Metric
R126: 1.65k / 0.1%; R_0603_1608Metric
R201: 1.62M 1%; R_0603_1608Metric
R202: 180k 1%; R_0603_1608Metric
R302, R303: 4.7k / FIT; R_0603_1608Metric
R401, R402, R405, R406: 100R / 0.1%; R_0603_1608Metric
R403, R404, R407, R408: 1M / 1%; R_0603_1608Metric
R506, R507: 680R / 0.1%; R_0603_1608Metric
R601: 0R / fit: 3.3 V; R_0603_1608Metric
R602: 0R / DNP: 5 V option; R_0603_1608Metric
R603, R604: 4.7k / DNP; R_0603_1608Metric
R701: 787k / 0.1%; R_0603_1608Metric
R704, R705: 100R; R_0603_1608Metric
R801: 5.1k; R_0603_1608Metric
R804: 1k / DNP; R_0603_1608Metric
RN501: 2x2k / 1:1 matched; Vishay_ACAS0606_AT_IEC
TP1001: GND; TestPoint_Pad_D1.0mm
TP1002: USB_5V; TestPoint_Pad_D1.0mm
TP1003: PACK_P; TestPoint_Pad_D1.0mm
TP1004: VSYS; TestPoint_Pad_D1.0mm
TP1005: VOUT_5V; TestPoint_Pad_D1.0mm
TP1006: HOST_3V3; TestPoint_Pad_D1.0mm
TP1007: POWER_EN; TestPoint_Pad_D1.0mm
TP1008: I2C_SCL; TestPoint_Pad_D1.0mm
TP1009: I2C_SDA; TestPoint_Pad_D1.0mm
TP1010: HE_3V0; TestPoint_Pad_D1.0mm
TP1011: HE_SENSE; TestPoint_Pad_D1.0mm
TP1012: O2_VMID; TestPoint_Pad_D1.0mm
TP1013: CHG_STAT_N; TestPoint_Pad_D0.8mm
TP1014: QON SERVICE; TestPoint_Pad_D0.8mm
U101: BQ25895RTWR; TI_RTW24_4x4_ThermalVias_ServicePad
U110: TUSB320LAIRWBR; Texas_X2QFN-12_1.6x1.6mm_P0.4mm
U111: PI3USB9201ZTAEX; PI3USB9201_UQFN2020_12_TypeC
U112: SN74AUP1G74DCUR; VSSOP-8_2.3x2mm_P0.5mm
U113: TPS3808G01DBVR; SOT-23-6
U114: TPS22950CQDDCRQ1; TI_DDC0006A
U115: TPS259470ARPWR; TI_RPW0010A
U201: TPS63020DSJR; TI_DSJ_14
U301: MAX17048G+; TDFN-8-1EP_2x2mm_P0.5mm_EP0.8x1.2mm
U302: LM66100DCKR; SOT-363_SC-70-6
U401, U502: ADS122C04IPWR; TSSOP-16_4.4x5mm_P0.65mm
U501, U702: TPS7A2030PDBVR; SOT-23-5
U701: TPS61023DRLR; SOT-563
U703: TXU0202DCUR; TI_DCU8_CompactSilk
U801: LTC2954CTS8-1; TSOT-23-8

Connections:
/01 CHARGING + BATTERY/BQ_BTST: C103.2, U101.21 (BTST)
/01 CHARGING + BATTERY/BQ_PMID: C102.1, U101.23 (PMID)
/01 CHARGING + BATTERY/BQ_QON_N: TP1014.1, U101.12 (~QON)
/01 CHARGING + BATTERY/BQ_REGN: C107.1, R101.1, U101.22 (REGN)
/01 CHARGING + BATTERY/BQ_SW: C103.1, L101.1, U101.19 (SW), U101.20 (SW)
/01 CHARGING + BATTERY/CHG_CE_N: Q101.3 (D), R104.2, U101.9 (~CE)
/01 CHARGING + BATTERY/CHG_STAT_N: TP1013.1, U101.4 (STAT)
/01 CHARGING + BATTERY/PACK_TS: J103.1, R101.2, R102.1, U101.11 (TS)
/02 SWITCHED 5 V/TPS_FB: R201.2, R202.1, U201.3 (FB)
/02 SWITCHED 5 V/TPS_VINA: C203.1, U201.1 (VINA)
BME_SCL: J601.3 (SCL), Q601.3 (D), R603.2
BME_SDA: J601.4 (SDA), Q602.3 (D), R604.2
BME_VIN: C601.1, J601.1 (VIN), R601.2, R602.2, R603.1, R604.1
BQ_ILIM: R103.1, U101.10 (ILIM)
BUTTON_LED_A: J802.1, R804.2
CHARGE_ARM: J104.2 (B), Q101.1 (G), R105.1
CHG_INT_N: J301.13, Q112.3 (D), R107.2, U101.7 (~INT)
CO_5V28: C702.1, C703.1, J701.1 (5.28V), R701.1, U701.6 (VOUT)
CO_FB: R701.2, R702.1, U701.1 (FB)
CO_LOGIC_3V0: C705.1, C708.1, U702.5 (OUT), U703.7 (VCCB)
CO_RX_3V0: R705.1, U703.8 (B1Y)
CO_RX_CABLE: J701.4 (CO_RX), R705.2
CO_SW: L701.2, U701.5 (SW)
CO_TX_3V0: R704.1, U703.1 (B2)
CO_TX_CABLE: J701.3 (CO_TX), R704.2
CO_UART_EN: J301.9, R703.1, U703.6 (OE)
CO_UART_RX: J301.10, U703.4 (A2Y)
CO_UART_TX: J301.12, U703.5 (A1)
GAUGE_ALERT_N: R301.2, U301.5 (ALRT)
GND: C101.2, C102.2, C104.2, C105.2, C106.2, C107.2, C108.2, C110.2, C111.2, C112.2, C113.2, C114.2, C115.2, C116.2, C201.2, C202.2, C203.2, C204.2, C205.2, C206.2, C301.2, C302.2, C303.2, C402.2, C403.2, C405.2, C406.2, C407.2, C408.2, C409.2, C501.2, C502.2, C503.2, C504.2, C506.2, C507.2, C508.2, C509.2, C601.2, C701.2, C702.2, C703.2, C704.2, C705.2, C706.2, C707.2, C708.2, C801.2, C802.2, C803.2, C804.2, J101.2, J102.2, J103.2, J301.5, J301.6, J301.16, J501.3, J601.2 (GND), J701.2 (GND), J801.2, J802.2, Q101.2 (S), Q111.2 (S), Q112.2 (S), R102.2, R103.2, R105.2, R114.2, R117.2, R118.2, R119.2, R123.2, R125.2, R126.2, R127.2, R128.2, R202.2, R410.2, R501.2, R505.2, R702.2, R703.2, RN501.3 (R2.2), TP1001.1 (1_1), U101.8 (OTG), U101.17 (PGND), U101.18 (PGND), U101.25 (PGND), U110.3 (PORT), U110.5 (ADDR), U110.10 (GND), U110.11 (EN_N), U111.9 (GND), U111.10 (ADDR), U111.11 (ENB), U112.4 (GND), U113.2 (GND), U114.3 (GND), U115.8 (GND), U201.2 (GND), U201.15 (PGND/EP), U301.1 (CTG), U301.4 (GND), U301.6 (QSTRT), U301.9 (EP), U302.2 (GND), U302.5 (ST), U401.1 (A0), U401.2 (A1), U401.4 (DGND), U401.5 (AVSS), U501.2 (GND), U502.2 (A1), U502.4 (DGND), U502.5 (AVSS), U701.4 (GND), U702.2 (GND), U703.2 (GND), U801.4 (GND)
HE_3V0: C502.1, J501.1, R504.1, RN501.1 (R1.1), TP1010.1 (1_1), U501.5 (OUT)
HE_AIN_N: C505.2, C507.1, R507.2, U502.10 (AIN1)
HE_AIN_P: C505.1, C506.1, R506.2, U502.11 (AIN0)
HE_ENABLE: J301.17, R501.1, U501.3 (EN)
HE_EXC_DIV: C504.1, R504.2, R505.1, U502.7 (AIN2)
HE_REF: R506.1, RN501.2 (R2.1), RN501.4 (R1.2)
HE_SENSE: J501.2, R507.1, TP1011.1 (1_1)
HOST_3V3: C110.1, C111.1, C112.1, C113.1, C407.1, C408.1, C508.1, C509.1, C707.1, J301.1, J301.3, J301.18, Q601.1 (G), Q602.1 (G), R107.1, R111.1, R112.1, R115.1, R120.1, R301.1, R302.1, R303.1, R409.1, R601.1, R802.1, R803.1, TP1006.1 (1_1), U110.12 (VDD), U111.12 (VDD), U112.2 (D), U112.7 (PRE_N), U112.8 (VCC), U113.6 (VDD), U401.3 (~RESET), U401.12 (AVDD), U401.13 (DVDD), U502.1 (A0), U502.3 (~RESET), U502.12 (AVDD), U502.13 (DVDD), U703.3 (VCCA)
HOST_5V: C303.1, J301.2, J301.4, U302.3 (CE), U302.6 (VOUT)
I2C_SCL: J301.14, Q601.2 (S), R302.2, TP1008.1 (1_1), U101.5 (SCL), U110.8 (SCL), U111.3 (SCL), U301.7 (SCL), U401.16 (SCL), U502.16 (SCL)
I2C_SDA: J301.21, Q602.2 (S), R303.2, TP1009.1 (1_1), U101.6 (SDA), U110.7 (SDA), U111.4 (SDA), U301.8 (SDA), U401.15 (SDA), U502.15 (SDA)
unnamed: J801.1, R801.1
unnamed: L201.1, U201.8 (L1), U201.9 (L1)
unnamed: L201.2, U201.6 (L2), U201.7 (L2)
unnamed: C803.1, U801.3 (ONT)
unnamed: C804.1, U801.7 (PDT)
O2_A_AIN_N: C401.1, C402.1, R401.2, R403.1, U401.10 (AIN1)
O2_A_AIN_P: C401.2, C403.1, R402.2, R404.2, U401.11 (AIN0)
O2_A_RAW_N: J401.2, R401.1
O2_A_RAW_P: J401.1, R402.1
O2_B_AIN_N: C404.1, C405.1, R405.2, R407.1, U401.6 (AIN3)
O2_B_AIN_P: C404.2, C406.1, R406.2, R408.2, U401.7 (AIN2)
O2_B_RAW_N: J402.2 (Ext), R405.1
O2_B_RAW_P: J402.1 (In), R406.1
O2_VMID: C409.1, R403.2, R404.1, R407.2, R408.1, R409.2, R410.1, TP1012.1 (1_1), U502.6 (AIN3)
PACK_P: C106.1, C301.1, J102.1, TP1003.1 (1_1), U101.13 (BAT), U101.14 (BAT), U301.2 (CELL), U301.3 (VDD)
PB_FILTERED_N: C802.1, R801.2, U801.2 (~PB)
POWER_EN: R203.2, TP1007.1 (1_1), U201.12 (EN), U801.6 (EN)
POWER_INT_N: J301.19, R802.2, U801.5 (~INT)
POWER_KILL_N: J301.8, R803.2, U801.8 (~KILL)
USB_5V: C115.1, J101.1, R110.1, R121.1, R124.1, TP1002.1 (1_1), U115.5 (IN)
USB_BC_INT_N: R112.2, U111.5 (INTB)
USB_CC1: J101.3, U110.1 (CC1)
USB_CC2: J101.4, U110.2 (CC2)
USB_CC_INT_N: R111.2, U110.6 (INT_N), U113.3 (MR), U115.3 (AUXOFF)
USB_CHG_5V: C101.1, U101.1 (VBUS), U114.5 (VOUT)
USB_D_M: J101.6, U111.7 (D-)
USB_D_P: J101.5, U111.8 (D+)
USB_ILIM_AUTH: J301.11, Q111.1 (G), R117.1, U112.1 (CLK)
USB_ILIM_BRANCH: Q110.3 (D), R116.2
USB_ILIM_SERIES: Q110.2 (S), Q111.3 (D)
USB_LIMIT_FAULT_N: R120.2, U114.6 (FLT)
USB_LIMIT_SET: R116.1, R119.1, U114.4 (ILIM)
USB_OVP_5V: C114.1, R113.1, R127.1, U114.1 (ON), U114.2 (VIN), U115.6 (OUT)
USB_OVP_DVDT: C116.1, U115.7 (DVDT)
USB_OVP_ILM: R126.1, U115.9 (ILM)
USB_OVP_SET: R122.2, R123.1, U115.2 (OVLO)
USB_OVP_UPPER: R121.2, R122.1
USB_OVP_UVLO: R124.2, R125.1, U115.1 (EN/UVLO)
USB_PERMISSION_CLR_N: R115.2, U112.6 (CLR_N), U113.1 (RESET)
USB_PERMISSION_Q: Q110.1 (G), R118.1, U112.5 (Q)
USB_PERMISSION_Q_N: Q112.1 (G), R128.1, U112.3 (Q_N)
USB_VBUS_DET: R110.2, U110.4 (VBUS_DET)
USB_VBUS_SENSE: R113.2, R114.1, U113.5 (SENSE)
VOUT_5V: C204.1, C205.1, C206.1, C302.1, C501.1, C701.1, C704.1, L701.1, R201.1, R602.1, R804.1, TP1005.1 (1_1), U201.4 (VOUT), U201.5 (VOUT), U302.1 (VIN), U501.1 (IN), U701.2 (EN), U701.3 (VIN), U702.1 (IN), U702.3 (EN)
VSYS: C104.1, C105.1, C108.1, C201.1, C202.1, C801.1, J104.1 (A), L101.2, R104.1, R203.1, TP1004.1 (1_1), U101.15 (SYS), U101.16 (SYS), U201.10 (VIN), U201.11 (VIN), U201.13 (PS/SYNC), U801.1 (VIN)
