magnus188/aegir/software/firmware/tests/test_ota_storage.cpp

#include "services/ota_core.h"
#include "services/c6_recovery_checks.h"
#include "services/blob_journal.h"
#include "services/storage_service.h"
#include "services/maintenance_service.h"
#include <cstdio>
#include <cstring>
#include <map>
#include <string>

namespace {
int passed = 0, failed = 0;
void check(bool ok, const char *label) { std::printf("%s %s\n", ok ? "PASS" : "FAIL", label); ok ? ++passed : ++failed; }
std::string release(const char *family = "pre3", const char *tag = "v0.3.0", const char *digest = "sha256:0123456789abcdef0123456789abcdef0123456789abcdef0123456789abcdef") {
    const std::string name = std::string("Trimix_analyzer_esp32p4_") + family + "_v0.3.0.bin";
    return std::string("{\"tag_name\":\"") + tag + "\",\"body\":\"Changes\",\"assets\":[{\"name\":\"" + name +
        "\",\"browser_download_url\":\"https://github.com/example/trimix/releases/download/" + tag + "/" + name +
        "\",\"size\":4096,\"digest\":\"" + digest + "\"}]}";
}
bool parse(const std::string &s, ota::Release &r, uint32_t slot = 4194304, ota::Family family = ota::Family::Pre3) {
    std::string error;
    return ota::parse_release(s.data(), s.size(), family, "0.2.0", "https://github.com/example/trimix", slot, r, error);
}
class Memory : public persistent::Backend {
public:
    std::map<std::string, std::vector<uint8_t>> data;
    int operations = 0, fail_at = -1;
    persistent::Read get(const char *key, std::vector<uint8_t> &v) override {
        if (operations++ == fail_at) return persistent::Read::Error;
        auto i = data.find(key); if (i == data.end()) return persistent::Read::Missing;
        v = i->second; return persistent::Read::Ok;
    }
    bool put(const char *key, const std::vector<uint8_t> &v) override {
        if (operations++ == fail_at) return false;
        data[key] = v; return true;
    }
};
class FlashModel : public ota::ImageTransport {
public:
    enum Failure { None, Begin, Identity, Transfer, Digest, Activation } failure = None;
    uint32_t clock = 0, bytes = 0;
    unsigned active_image = 1, writes = 0, activations = 0, aborts = 0;
    bool cancel = false, complete_data = true, oversized = false, cancel_after_digest = false;
    bool begin() override { return failure != Begin; }
    bool identity(ota::ImageIdentity &out) override {
        std::snprintf(out.project, sizeof(out.project), "%s", failure == Identity ? "wrong" : "Trimix_analyzer");
        std::snprintf(out.version, sizeof(out.version), "0.3.0"); return true;
    }
    ota::TransferStep transfer() override {
        clock += 1000; ++writes;
        if (failure == Transfer && writes == 2) return ota::TransferStep::Error;
        bytes += oversized ? 8192 : 1024;
        return bytes >= 4096 ? ota::TransferStep::Complete : ota::TransferStep::More;
    }
    uint32_t received() override { return bytes; }
    bool complete() override { return complete_data; }
    bool digest_matches() override { if (cancel_after_digest) cancel = true; return failure != Digest; }
    bool activate() override { ++activations; if (failure == Activation) return false; active_image = 2; return true; }
    void abort() override { ++aborts; }
    bool cancelled() override { return cancel; }
    uint32_t now_ms() override { return clock; }
};
int stops = 0, resumes = 0, flushes = 0;
bool power = true, stop_ok = true, flush_ok = true;
bool stop(uint32_t ms) { ++stops; return ms && stop_ok; }
bool flush(uint32_t ms) { ++flushes; return ms && flush_ok; }
void resume() { ++resumes; }
bool allowed() { return power; }
}
int main() {
    ota::BootProbation probation;
    probation.begin(100, true);
    check(probation.pending() && !probation.expire(60099), "Pending OTA startup remains inside its 60-second total deadline");
    check(probation.complete(60099) == ota::BootProbation::Completion::Timely && !probation.expire(60100),
          "Successful startup completion prevents a later supervisor rollback");
    probation.begin(100, true);
    check(probation.expire(60100) && !probation.pending(), "Supervisor expires essential startup even before the post-init health loop");
    check(probation.complete(60101) == ota::BootProbation::Completion::AlreadyExpired && !probation.expire(60102),
          "Expired startup cannot subsequently accept itself or repeat rollback ownership");
    probation.begin(100, true);
    check(probation.complete(60100) == ota::BootProbation::Completion::Timeout && !probation.expire(60101),
          "Main task arriving at the deadline owns timeout once even if supervisor has not run yet");
    probation.begin(UINT32_MAX - 100, true);
    check(!probation.expire(59898) && probation.expire(59899), "Startup deadline remains correct across millisecond clock wrap");
    probation.begin(0, false);
    check(!probation.pending() && !probation.expire(60000) && probation.complete(60001) == ota::BootProbation::Completion::Timely,
          "An already accepted image has no OTA probation rollback deadline");
    uint32_t numbers[3];
    check(ota::version("v12.34.56", numbers) && numbers[1] == 34, "Semantic release version parsed");
    for (const char *bad : {"", "1.2", "1.2.3beta", "-1.2.3", "999999999999.2.3", "1.2.3.4", "1..3"})
        check(!ota::version(bad, numbers), "Malformed/overflow version rejected");
    ota::Response response;
    check(response.append("abc", 3) && response.append("def", 3) && response.body() == "abcdef", "Chunked response fragments retained");
    std::string large(32769, 'x');
    check(!response.append(large.data(), large.size()) && response.overflowed(), "Oversize response fails instead of silently truncating");
    response.clear(); check(response.body().empty() && !response.overflowed(), "Retry starts with a clean response");
    ota::Release output;
    check(parse(release(), output) && output.newer && output.size == 4096 && output.sha256[0] == 1, "Compatible exact application asset and SHA selected");
    check(parse(release("v3"), output, 6291456, ota::Family::V3), "V3 family selects its own application image");
    check(!parse(release("v3"), output), "Wrong silicon family rejected");
    check(!parse(release("pre3_factory"), output), "Factory binary is never an OTA candidate");
    check(!parse(release(), output, 1024), "Installed slot size limits update");
    check(!parse(release("pre3", "v0.3.0", ""), output), "Missing release digest rejected");
    auto malformed = release(); malformed.replace(malformed.find("4096"), 4, "-1");
    check(!parse(malformed, output), "Negative firmware size rejected");
    malformed = release(); malformed.replace(malformed.find("https://github.com/example/trimix/releases"), 5, "http");
    check(!parse(malformed, output), "Non-HTTPS or mismatched asset URL rejected");
    malformed = release(); auto a = malformed.find("[{"), b = malformed.rfind("}]");
    const auto asset = malformed.substr(a + 1, b - a); malformed.insert(b + 1, "," + asset);
    check(!parse(malformed, output), "Duplicate matching assets rejected");
    malformed = release(); malformed.insert(malformed.find("Changes"), 6000, 'a');
    check(parse(malformed, output) && output.notes.size() == 255, "Large valid metadata accepted with bounded display notes");
    malformed.push_back('x'); check(!parse(malformed, output), "Trailing malformed JSON rejected");
    check(ota::image_identity("Trimix_analyzer", "0.3.0", "Trimix_analyzer", "0.3.0") &&
          !ota::image_identity("other", "0.3.0", "Trimix_analyzer", "0.3.0"), "Downloaded descriptor must match project and release version");
    check(!ota::boot_healthy(3, true) && !ota::boot_healthy(9, false) && ota::boot_healthy(4, true), "Boot acceptance requires UI heartbeat and responsive worker");
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
