magnus188/aegir/(commit log)

2026-09-25 Organize project and brand it as Ziphius
    [0402-initial.kicad_pcb, 0402-raw.kicad_pcb, Amphenol_RF_142138_Drawing_Reconstruction.step, C01_gas_inlet_no_support_baseline_petg.3mf, C01_gas_inlet_no_support_baseline_pla.3mf, C02_gas_return_no_support_baseline_petg.3mf, C02_gas_return_no_support_baseline_pla.3mf, C103-0402-B-scout.kicad_pcb]
2026-09-25 Update partitions.csv naming for Ægir
    [partitions.csv]
2026-09-25 Update partitions.esp32p4.pre3.csv naming for Ægir
    [partitions.esp32p4.pre3.csv]
2026-09-26 Simplify application structure and remove obsolete code
    [partitions.csv, partitions.esp32p4.pre3.csv]
2026-09-26 Fix GCC warnings in host test fixtures
    [test_charge_standby.cpp, test_co_hardware_worker.cpp, test_power_worker_standby.cpp, test_sd_log.cpp, test_usb_input_path.cpp]
2026-09-26 Fix draft release asset URL verification
    [test_release_validation.py, verify_release.py]
2026-09-26 docs: simplify project README and consolidate guides [skip ci]
    [generate_splash_assets.py]
2026-09-27 chore: release v0.3.0 [skip ci]
    [version.h]
2026-09-28 feat(ui): refine analyser screens and device settings
2026-09-28 chore: release v0.4.0 [skip ci]
    [version.h]
2026-09-30 chore: release v0.4.3 [skip ci]
    [version.h]
2026-09-30 chore: release v0.4.4 [skip ci]
    [version.h]
2026-09-30 docs: show device concept render in README
2026-09-30 chore: release v0.4.5 [skip ci]
    [version.h]
2026-09-30 docs: publish PCB review gallery and project media
2026-09-30 chore: release v0.4.7 [skip ci]
    [version.h]
2026-10-03 fix: harden planner calculations and simulator UI workflows
    Correct planner gas math and lock handling, validate safety settings and oxygen IDs, guard LVGL chart gaps against overflow, and fix Wi-Fi, update, and browser loading states. Add mathematical property checks and real LVGL interaction regressions.
    Validation: 98 repository checks and 64 CTest cases pass, including ASan/UBSan; concurrency checks pass under TSan; both ESP-IDF hardware variants and WebAssembly build successfully; Chromium and WebKit UI workflows pass at desktop and mobile sizes. Physical-device behavior remains unverified.
    [main.cpp, oxygen_selection_core.cpp, oxygen_selection_core.h, oxygen_selection_service.cpp, oxygen_selection_service.h]
2026-10-03 chore: release v0.4.8 [skip ci]
    [version.h]
2026-10-03 chore: release v0.4.9 [skip ci]
    [version.h]
2026-10-04 chore: release v0.4.10 [skip ci]
    [version.h]
2026-10-07 fix(deps): update CairoSVG in hardware review environments (#31)
    Updates CairoSVG from 2.8.2 to 2.9.0 in both the main-board and USB
    hardware-review lockfiles, fixing GHSA-f38f-5xpm-9r7c in both
    environments. The original Dependabot change covered only the main-board
    environment.
    The review documentation distinguishes maintained dependencies for new
    runs from the versions and hashes in historical audit evidence. Existing
    receipts, install reports and rendered results are preserved.
    Validation:
    - Installed the complete pinned environment on Python 3.14.6; `pip
    check` passed.
    - Ran the production main-board audit with CairoSVG 2.9.0: 44 checks
    passed, zero failures.
    - Ran the production USB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
2026-10-07 fix(deps): update Werkzeug in hardware review environments (#30)
    Updates Werkzeug from 3.1.8 to 3.1.9 in both the main-board and USB
    hardware-review lockfiles, fixing GHSA-g6x2-hccm-hh4m in both
    environments.
    - `pip check` passed with the final pinned combination of Werkzeug 3.1.9
    and CairoSVG 2.9.0.
    - Flask and Quart test-client requests, safe path joining, and CairoSVG
    PNG rendering passed on Python 3.14.6.
    - Both review lockfiles contain the same dependency versions.
    - Required GitHub CI validates both P4 firmware builds, simulator
    checks, and workflow syntax on the updated branch.
    AI assistance extended the update to the companion lockfile. Historical
    hardware-audit receipt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
2026-10-17 update docs (#39)
    ## Problem and change
    Adds the maintainer-approved acknowledgement to README, thanking the
    contributor for reviewing and improving the PCB design and helping keep
    the project moving forward.
    ## Related issue
    Recognizes the contribution in #36.
    ## Verification
    - Checked the text against the requested wording and verified the
    contributor profile link.
    - `git diff --check` passed.
    - README only; no runtime tests were needed locally. Required GitHub
    checks will run.
    ## Limitations and review needed
    The acknowledgement was drafted with AI assistance and approved by the
    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
2026-10-17 fix(ci): release only when firmware build inputs change (#41)
    Every push to `main` currently builds and publishes new firmware,
    including PCB, enclosure, README, and workflow dependency updates. Add a
    read-only change-detection job so automatic publication runs only when
    ESP-IDF firmware build inputs change. Documentation, hardware, tests,
    simulator, web-demo, and workflow-only changes skip the entire
    build/version/publication job; manual releases remain available on
    `main`.
    The detector compares the full push, including deletions and both sides
    of renames, without GitHub path-filter limits. Release concurrency
    applies only to actual publication jobs so an unrelated p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
2026-10-17 Deliver integrated bottom USB-C PCB and matching Ægir enclosure (#42)
    Integrate the bottom USB-C connector on the main PCB and deliver its
    matching enclosure, including the Ægir symbol and original runes above
    the touchscreen. The logo is flush with the front and uses separate
    white material volumes for two-color printing, preserving the original
    outer shape and wall thickness.
    - Replace the separate USB board and harness with a GCT USB4105-GF-A on
    the main PCB; retain the battery holder, cell positions and PCM
    arrangement.
    - Update the existing Fusion/STEP files and Bambu H2D project in place.
    The nine-part print plate assigns gray to the left nozzle and white to
    t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
2026-10-17 Replace README concept imagery with accurate CAD product renders (#43)
    The README showed an AI concept image and an older open-case CAD
    preview. Replace them with dark studio renders of the current enclosure,
    including its flush white logo, bottom USB-C opening, current firmware
    demo screen, and the populated board exported directly from KiCad.
    Include full-resolution portrait/exploded PNGs, optimized README copies,
    packed Blender scenes, reproducible scripts, source hashes, and
    reference notes. Preserve the historical images and existing
    prototype-status wording. No CAD, PCB, firmware, or manufacturing files
    change.
    No linked issue.
    ## Verificatio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
2026-10-18 Update README (#44)
    Removed outdated PCB and enclosure details, and simplified descriptions
    in the README.
    <!-- Explain what was wrong or missing and what happens after this
    change. -->
    <!-- Use "Refs #123" for partial work; "Closes #123" only when the issue
    is complete. -->
    <!-- List the checks actually run and their results. For software,
    include make test
    and relevant builds. For hardware, link editable sources, calculations,
    datasheets and measurements. State which results are simulated. -->
    <!-- Name anything untested, assumptions, compatibility changes and
    failure cases.
    For measurement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
